ostojaatanasijevic/voltmeter_module/voltmeter_module.pdf

## MCP3651 based voltmeter module

10. januar 2025.

## Sadrˇzaj

1 Resolution | 3
2 Input amplifier ideas | 3
3 Calculating errors | 5
4 Power supply | 7

## 1 Resolution

MCP3651 ADC has a resolution of 24 bits, however, the 7 ppm max INL limits this multimeters count to 146000, just shy of 5.5 digit.
Keeping drift in 1 PPM range, 3 uV drift is acceptable over the temperature range.

1.1 Input current noise limit

Since for input ranges greater then Vcc the input voltage is feed through a 10 MOhm divider, input currents noise contribution is:

## 2 Input amplifier ideas

2.1 NCS21802 only

2.1.1 Input current noise at high voltage input NCS21802 has 450 fA√
Hz, meaning at input divider resistance (around 12 kOhm), voltage noise generated is 5.4nV/

√
Hz. At 1 kHz BW, peak to peak noise contribution of input current is 1.02 uVpp. At 1 Hz, input noise is 32 nVpp.

2.1.2 Input current noise at low voltage input

2.1.3 Input voltage noise

NCS has 400 nVpp below 10 Hz, while the 1 kHz noise spec of 42 nV/Hz would suggest 800 nVpp at that BW. If we use the 1 kHz figure, we can estimate 1 kHz BW noise is 8 uVpp. At 1 Hz, input voltage noise is 252 nVpp or less.

2.1.4 Total noise at high voltage input

Total noise is dominated by voltage noise, which is say 9 uVpp at 1 kHz, 260 nVpp at 1 Hz. Scaling to input range, 3V signal still has to go into the high voltage divider and is reduced to 4.5 mV.

2.1.5 IDK

If we want 500 updates a second, setting the bandwidth to 1000 Hz admits 1716 nVrms, or 10.3 uVpp of noise. Reducing the BW to 4 Hz, 0.6 uVpp.
With the proposed 10 Meg, 12.5 k divider, worst case scenario is 3V input voltage, yealding 3.75 mV across the input divider. In this case, noise reduces the voltmeter resolution to 500 counts. Averaging may improve this noise, but this is garantied to

2.2 TL072 and NCS
TL072 has 80 fA√
Hz, meaning at input divider resistance (around 100 kOhm), voltage noise generated is 8nV/

√
Hz. Noise is larger at 0.1 Hz, with peak to peak noise being 300 times larger then noise density at 1 kHz. Max pp noise is then 2.4 uVpp. The input voltage noise pp is 9.2 uVpp.

Vnoise =

p
9.2

2 + 2.4

2uV pp = 9.51uV pp | (1)

In order to retain the 5.5 digit resolution, input range cant go lower than 2V. At 4.5, input range is 0.2V.
If we want 500 updates a second, setting the bandwidth to 1000 Hz admits 1716 nVrms, or 10.3 uVpp of noise. Reducing the BW to 4 Hz, 0.6 uVpp.
With the proposed 10 Meg, 12.5 k divider, worst case scenario is 3V input voltage, yealding 3.75 mV across the input divider. In this case, noise reduces the voltmeter resolution to 500 counts.

2.3 Bootstrapped low voltage chopper amplifier input

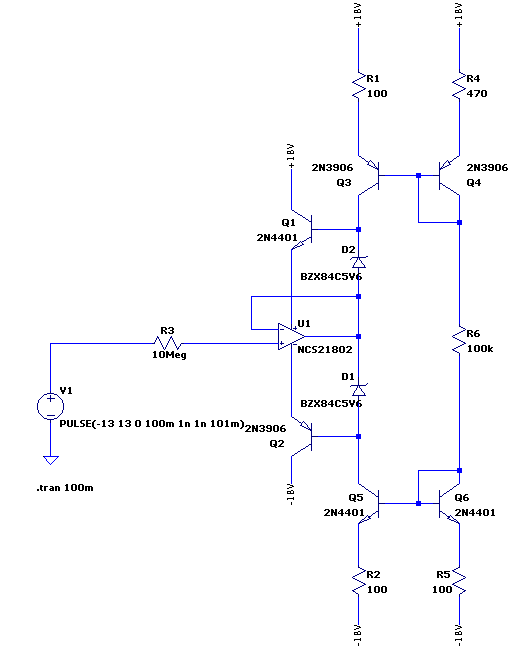
[picture p1: figure]

## 3 Calculating errors

3.1 Offset drift

The input stage is TL072 has typical of ±2 µV/°C and since the input stage features 2, one generating offset, total input drift is ±4 µV/°C.
This drift is lowered, as ±10V range gets mapped to 3.3 V range, meaning the offset drift contribution of TL072 is ±0.66µV/
◦C

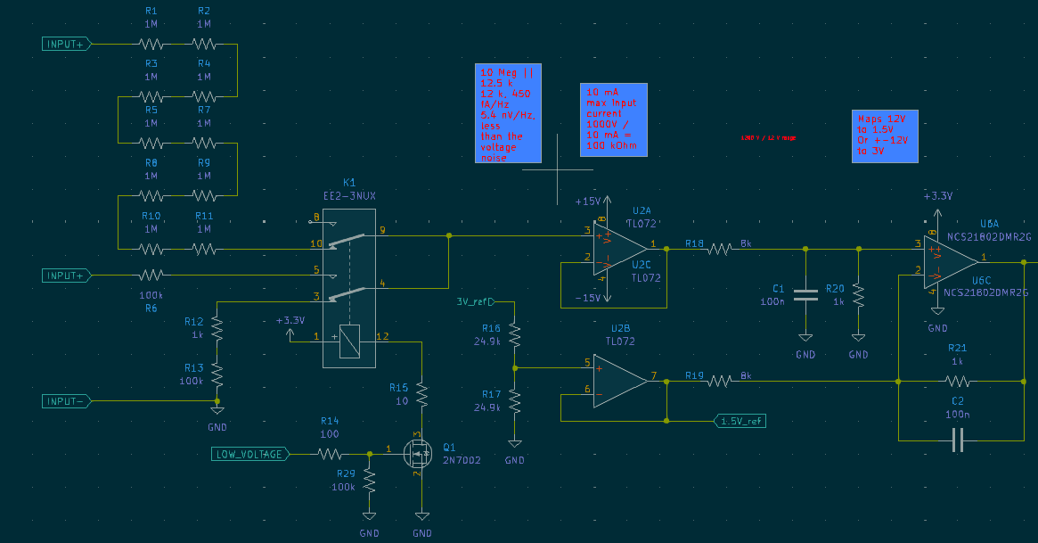
[picture p2: figure]

The second stage consist of two opamps, component NCS21802, with input offset of ±5 nV/°C. First opamp contributes ±5 nV/°C, while second opamps contribution depends on the selected gain. In the worst case, gain of 100, the second opamps contribution is ±0.5 µV/°C.
The ADC has an input offset drift of ±4 nV/°C, meaning the total input offset drift is:
Vos = Vtl072 + VNCS21802(1 + 100) + VADC | (2)

Vos = ±1.169µV/

◦C | (3)

Compared to full scale, drift is 0.35 PPM/°C, meaning for a 5.5 digit instrument, the drift is les than ±1 LSB for a temperature change of ±14 ◦C.

3.2 Gain drift

5.5 digit instruments have 5 PPM resolution.

## 4 Power supply

4.1 Mains transformer

Since leakage is not critical a this stage, +-18V mains transformer should suffice.
