ostojaatanasijevic/voltmeter_module/simulacije/002_bootstrapped_input_buffer.asc

D1: zener; PH_BZX884-B2V4
D2: zener; PH_BZX884-B2V4
Q1: npn; BC846B
Q2: npn; BC846B
Q3: pnp; BC856B
Q4: pnp; BC856B
Q5: npn; BC846B
Q7: pnp; BC856B
R1: res; 100
R2: res; 100
R3: res; 10Meg
R4: res; 470
R5: res; 100
R6: res; 100k
R7: res; 8k
R8: res; 8k
R9: res; 2k
R10: res; 1k
R11: res; 2k
R12: res; 2k
U1: opamp2; NCS21802
U2: opamp2; NCS21802
V1: voltage; PULSE(-12 12 0 100m 1n 1n 101m)
V2: voltage; 15V
V3: voltage; 15V
V4: voltage; 3
Named nets: 0, +18V, -18V
.tran 100m
.lib "NCS2180X SPICE MODEL.MOD"
