ostojaatanasijevic/voltmeter_module/simulacije/diode_check.asc

D1: zener; PH_BZX884-B2V4
D2: zener; PH_BZX884-B2V4
D3: zener; PH_BZX884-B2V4
Q1: pnp; 2N3906
R1: res; 20k
R2: res; 20k
R3: res; 20k
V1: voltage; 15V
V2: voltage; 15V
Named nets: +18V, 0
.lib "NCS2180X SPICE MODEL.MOD"
.tran 1m
