ostojaatanasijevic/voltmeter_module/simulacije/001_tl_ncs_combo.asc

R1: res; 10Meg
R2: res; 101k
R3: res; 2k
R4: res; 2k
R5: res; 2k
R6: res; 2k
R7: res; 2k
R8: res; 2k
R9: res; 2k
U1: TL072
U3: TL072
V1: voltage; 15
V2: voltage; -15
V3: voltage; -5
V4: voltage; 5
V5: voltage; PULSE(-1200 1200 0 10m 1u 1u 11m)
V6: voltage; 3
Named nets: 15V, -15V, 0, -5V, 5V, 3V
.tran 10m
