ostojaatanasijevic/voltmeter_module/simulacije/200_temperature_sensor.asc

B1: bv; V=575m + 2.64m * (V(temp) - 25)
R1: res; {Rf}
R2: res; {Rin}
R3: res; {Rin}
R4: res; {Rf}
R5: res; 4.7k
R6: res; 1k
U1: TL072
U2: TL072
V1: voltage; 15
V2: voltage; 15
V3: voltage; 3
V4: voltage; PULSE(0 50 0 100m 1u 1u 101m)
Named nets: 0, 15V, -15V, temp
.tran 102m
.param Rin = 1k
.param Rf = 25k
