ostojaatanasijevic/voltmeter_module/simulacije/100_push_pull.asc

C1: cap; 100p
C2: cap; 47µ
C3: cap; 10µ
C4: cap; 10µ
C5: cap; 47µ
C9: cap; 10µ
C10: cap; 10µ
C11: cap; 10µ
C12: cap; 10µ
D1: schottky; RB088LAM100
D2: schottky; RB088LAM100
I3: current; 50m
I4: current; 50m
L1: ind2; 1.8m; Rser=0.2
L2: ind2; 1.8m; Rser=0.2
L3: ind2; 900µ; Rser=0.4
L4: ind2; 900µ; Rser=0.4
M1: nmos; 2N7002
M2: nmos; 2N7002
Q2: pnp; 2N2905
R1: res; 1k
R2: res; 10
R3: res; 10
R4: res; 2.2k
R5: res; 1k
R6: res; 2.2k
U1: bd679
V2: voltage; PULSE(0 10 {0.5/f} 10n 10n {d/f}   {1/f})
V3: voltage; PULSE(0 10 {0} 10n 10n {d/f} {1/f})
V4: voltage; 12
Named nets: 0, GATE_B, GATE_A, -V_DRV_HS, +V_DRV_HS, vcc_in
.tran 100m
K1  L1 L2 L3 L4 1
.param f = 20k
.param d=0.4
