ostojaatanasijevic/voltmeter_module/simulacije/000_input_protection.asc

R3: res; 10Meg
U1: opamp2; NCS21802
V1: voltage; PULSE(-1000 1000 0 100m 1n 1n 101m)
V2: voltage; 5
Named nets: 0, 3.3V
.tran 100m
.lib "Z:\\home\\ostoja\\Elektronika\\voltmeter_module\\simulacije\\NCS2180X SPICE MODEL.MOD"
