ostojaatanasijevic/voltmeter_module/voltmeter_module.kicad_pcb

## KiCad design voltmeter_module.kicad_pcb (2025-01-10)

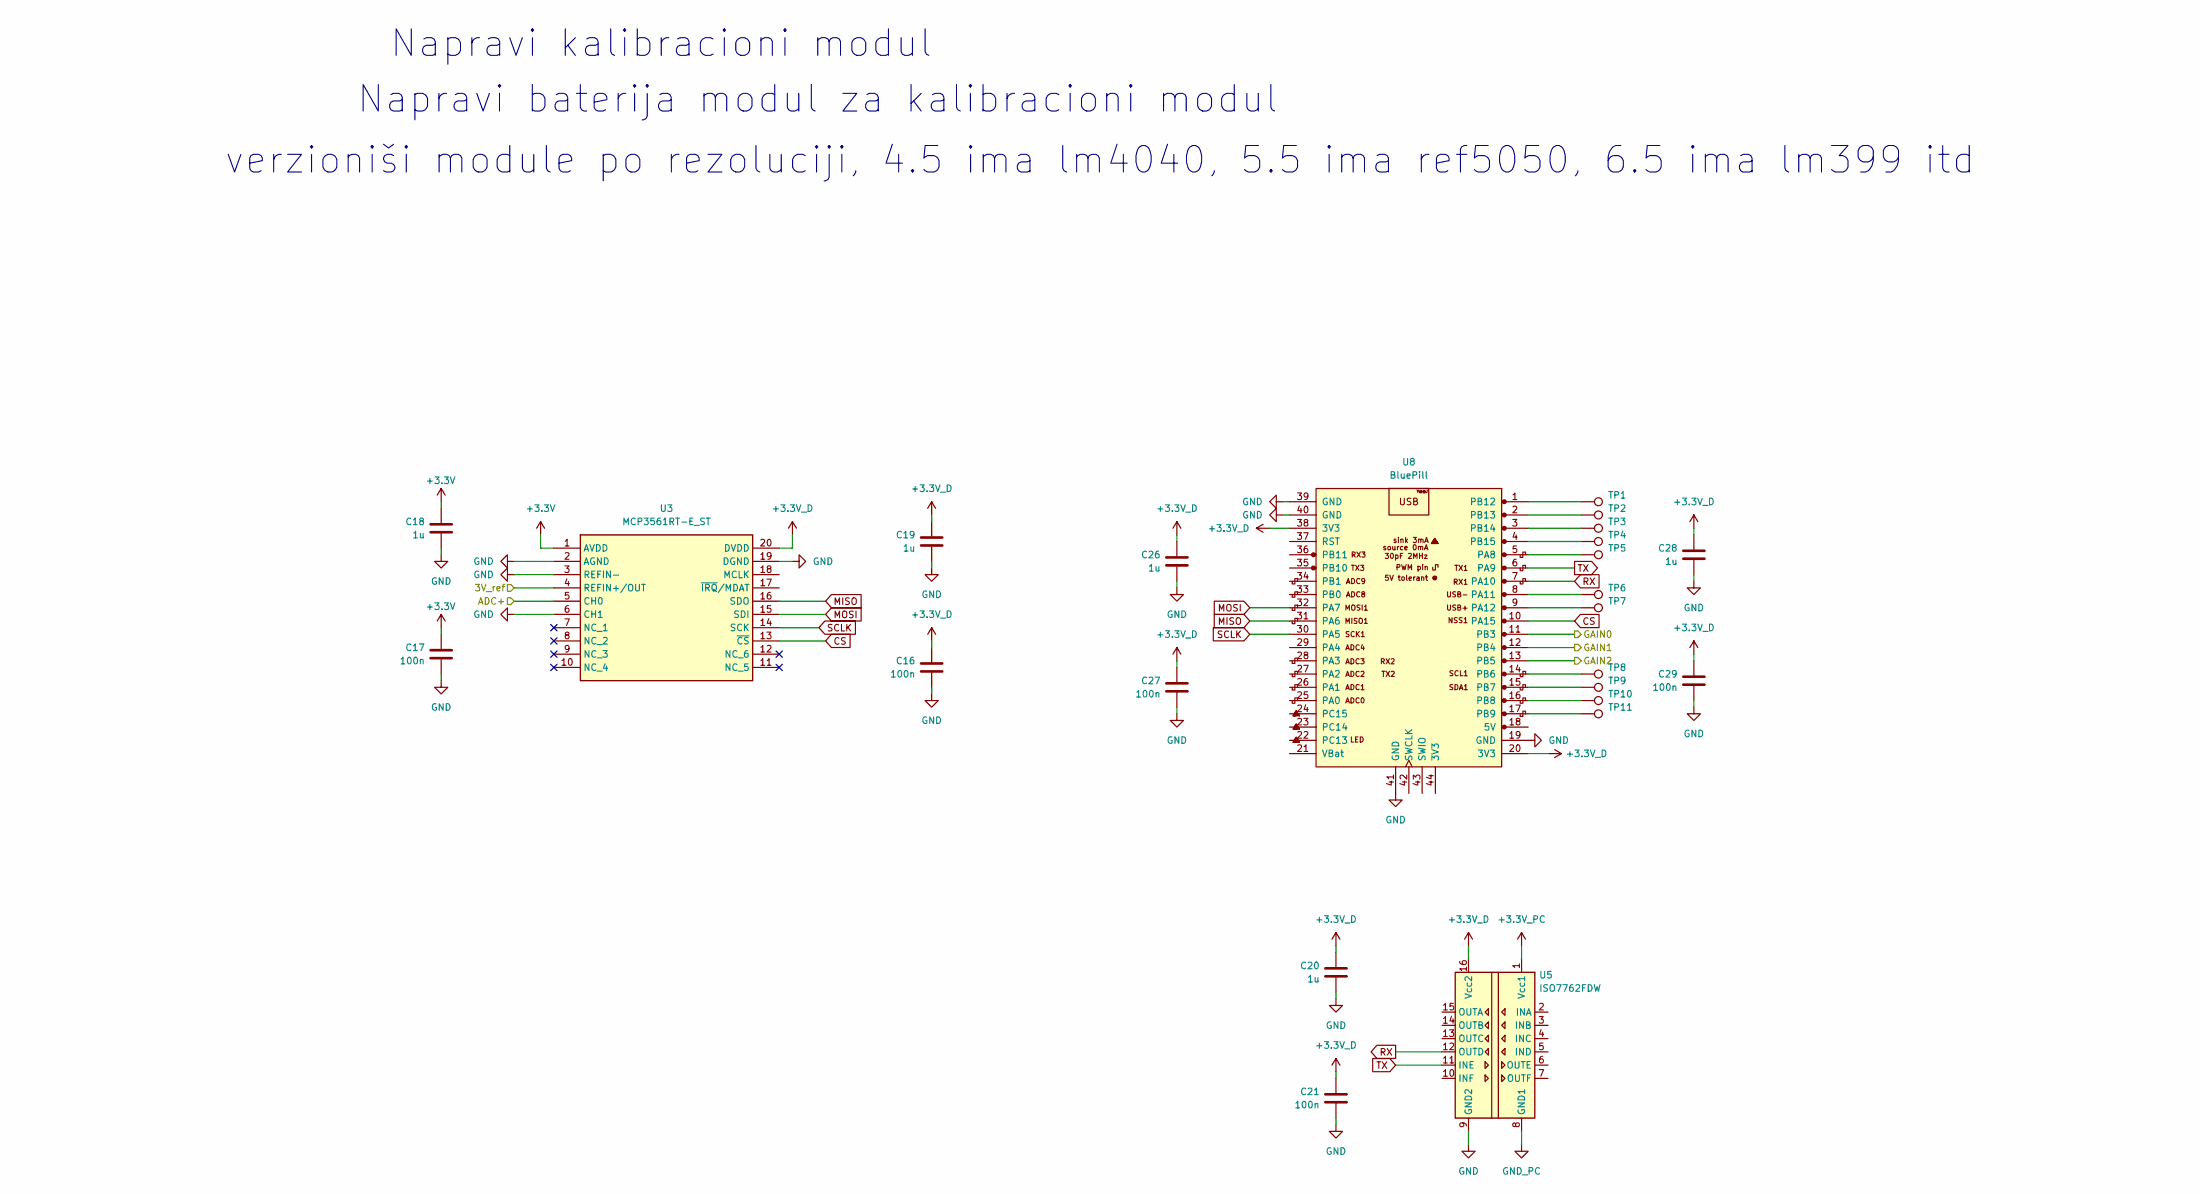
[picture p3: schematic digital_section.kicad_sch]

Parts:
C16, C17, C21, C27, C29: 100n; C_0603_1608Metric_Pad1.08x0.95mm_HandSolder
C18, C19, C20, C26, C28: 1u; C_0603_1608Metric_Pad1.08x0.95mm_HandSolder
TP1, TP2, TP3, TP4, TP5, TP6, TP7, TP8, TP9, TP10, TP11: TestPoint; TestPoint_Pad_D3.0mm
U3: MCP3561RT-E_ST; TSSOP-20_4.4x6.5mm_P0.65mm; Mouser Part Number 579-MCP3561RT-E/ST
U5: ISO7762FDW; SOIC-16W_7.5x10.3mm_P1.27mm
U8: BluePill

Connections:
+3.3V: C17.2, C18.2, U3.1 (AVDD); also elsewhere on the board
+3.3V_D: C16.2, C19.2, C20.2, C21.2, C26.2, C27.2, C28.2, C29.2, U3.20 (DVDD), U5.16 (Vcc2), U8.20 (3V3), U8.38 (3V3); also elsewhere on the board
+3.3V_PC: U5.1 (Vcc1); also elsewhere on the board
/Digital section/3V_ref: U3.4 (REFIN+/OUT); also elsewhere on the board
/Digital section/ADC+: U3.5 (CH0); also elsewhere on the board
CS: U3.13 (~CS), U8.10 (PA15)
GND_PC: U5.8 (GND1); also elsewhere on the board
INPUT-: C16.1, C17.1, C18.1, C19.1, C20.1, C21.1, C26.1, C27.1, C28.1, C29.1, U3.2 (AGND), U3.3 (REFIN-), U3.6 (CH1), U3.19 (DGND), U5.9 (GND2), U8.19 (GND), U8.39 (GND), U8.40 (GND), U8.41 (GND); also elsewhere on the board
MISO: U3.16 (SDO), U8.31 (PA6)
MOSI: U3.15 (SDI), U8.32 (PA7)
unnamed: TP5.1, U8.5 (PA8)
unnamed: TP6.1, U8.8 (PA11)
unnamed: TP7.1, U8.9 (PA12)
unnamed: TP8.1, U8.14 (PB6)
unnamed: TP9.1, U8.15 (PB7)
unnamed: TP10.1, U8.16 (PB8)
unnamed: TP11.1, U8.17 (PB9)
unnamed: TP1.1, U8.1 (PB12)
unnamed: TP2.1, U8.2 (PB13)
unnamed: TP3.1, U8.3 (PB14)
unnamed: TP4.1, U8.4 (PB15)
RX: U5.12 (OUTD), U8.7 (PA10)
SCLK: U3.14 (SCK), U8.30 (PA5)
TX: U5.11 (INE), U8.6 (PA9)

Notes on the sheet:
verzioniši module po rezoluciji, 4.5 ima lm4040, 5.5 ima ref5050, 6.5 ima lm399 itd
Napravi kalibracioni modul
Napravi baterija modul za kalibracioni modul

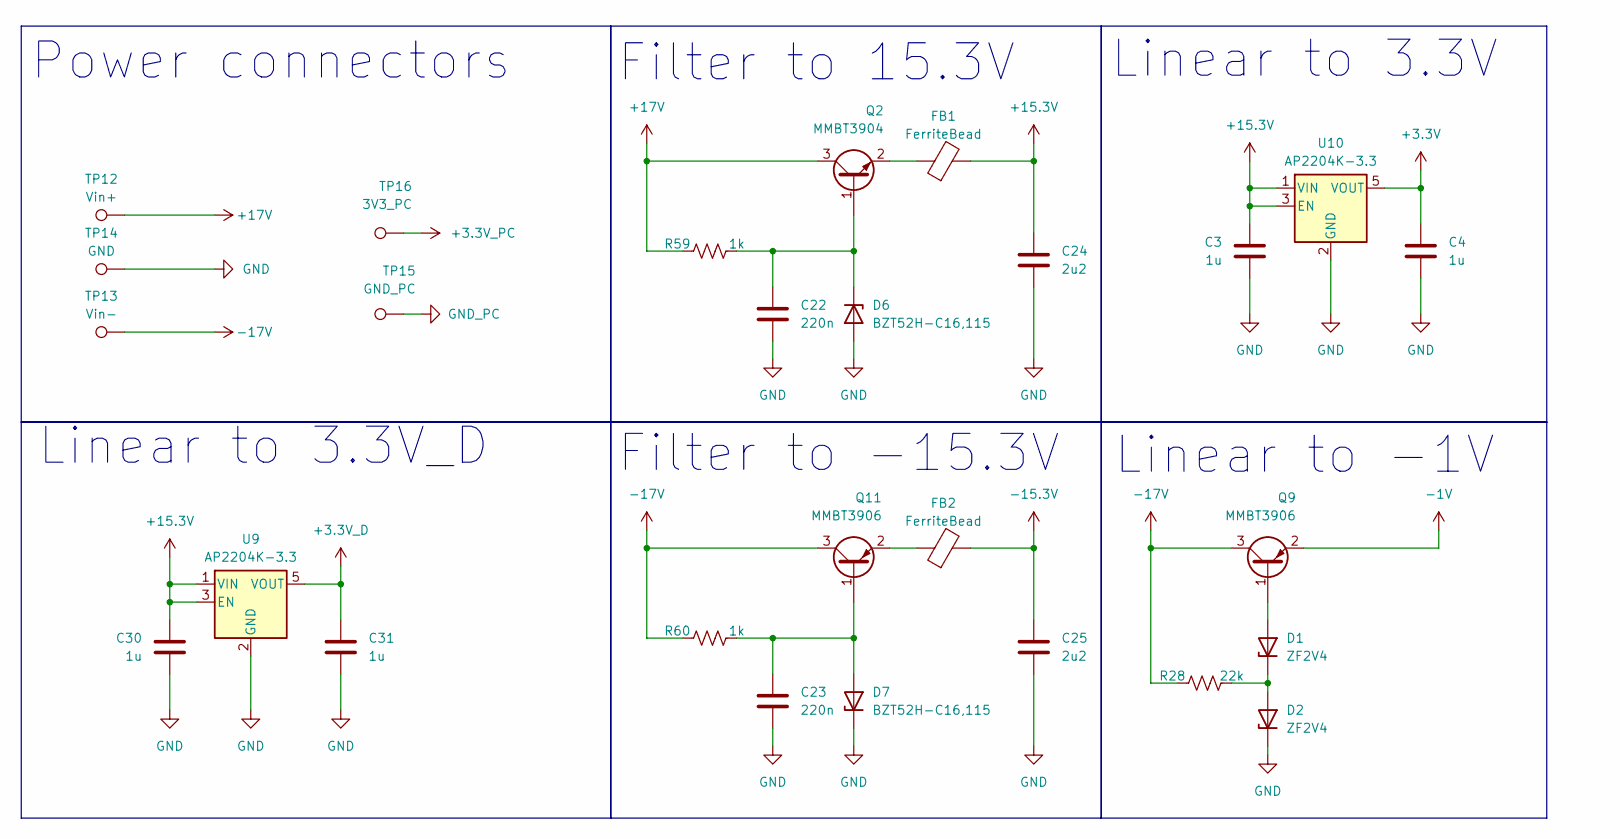
[picture p4: schematic power_supply.kicad_sch]

Parts:
C3, C4, C30, C31: 1u; R_0603_1608Metric_Pad0.98x0.95mm_HandSolder
C22, C23: 220n; R_0603_1608Metric_Pad0.98x0.95mm_HandSolder
C24, C25: 2u2; R_1206_3216Metric_Pad1.30x1.75mm_HandSolder
D1, D2: ZF2V4; D_DO-35_SOD27_P7.62mm_Horizontal
D6, D7: BZT52H-C16,115; D_SOD-123F
FB1, FB2: FerriteBead
Q2: MMBT3904; SOT-23
Q9, Q11: MMBT3906; SOT-23
R28: 22k; R_0603_1608Metric_Pad0.98x0.95mm_HandSolder
R59, R60: 1k; R_0603_1608Metric_Pad0.98x0.95mm_HandSolder
TP12: Vin+; TestPoint_THTPad_D4.0mm_Drill2.0mm
TP13: Vin-; TestPoint_THTPad_D4.0mm_Drill2.0mm
TP14: GND; TestPoint_THTPad_D4.0mm_Drill2.0mm
TP15: GND_PC; TestPoint_THTPad_D4.0mm_Drill2.0mm
TP16: 3V3_PC; TestPoint_THTPad_D4.0mm_Drill2.0mm
U9, U10: AP2204K-3.3; SOT-23-5

Connections:
+3.3V: C4.1, U10.5 (VOUT); also elsewhere on the board
+3.3V_D: C31.1, U9.5 (VOUT); also elsewhere on the board
+3.3V_PC: TP16.1; also elsewhere on the board
+15.3V: C3.1, C24.2, C30.1, FB1.2, U9.1 (VIN), U9.3 (EN), U10.1 (VIN), U10.3 (EN); also elsewhere on the board
+17V: Q2.3 (C), R59.2, TP12.1
-1V: Q9.2 (E); also elsewhere on the board
-15.3V: C25.2, FB2.2; also elsewhere on the board
-17V: Q9.3 (C), Q11.3 (C), R28.2, R60.2, TP13.1
GND_PC: TP15.1; also elsewhere on the board
INPUT-: C3.2, C4.2, C22.2, C23.2, C24.1, C25.1, C30.2, C31.2, D2.1 (K), D6.2 (A), D7.1 (K), TP14.1, U9.2 (GND), U10.2 (GND); also elsewhere on the board
unnamed: D1.2 (A), Q9.1 (B)
unnamed: D1.1 (K), D2.2 (A), R28.1
unnamed: C22.1, D6.1 (K), Q2.1 (B), R59.1
unnamed: C23.1, D7.2 (A), Q11.1 (B), R60.1
unnamed: FB1.1, Q2.2 (E)
unnamed: FB2.1, Q11.2 (E)

Notes on the sheet:
Linear to 3.3V_D
Filter to 15.3V
Linear to -1V
Power connectors
Linear to 3.3V
Filter to -15.3V

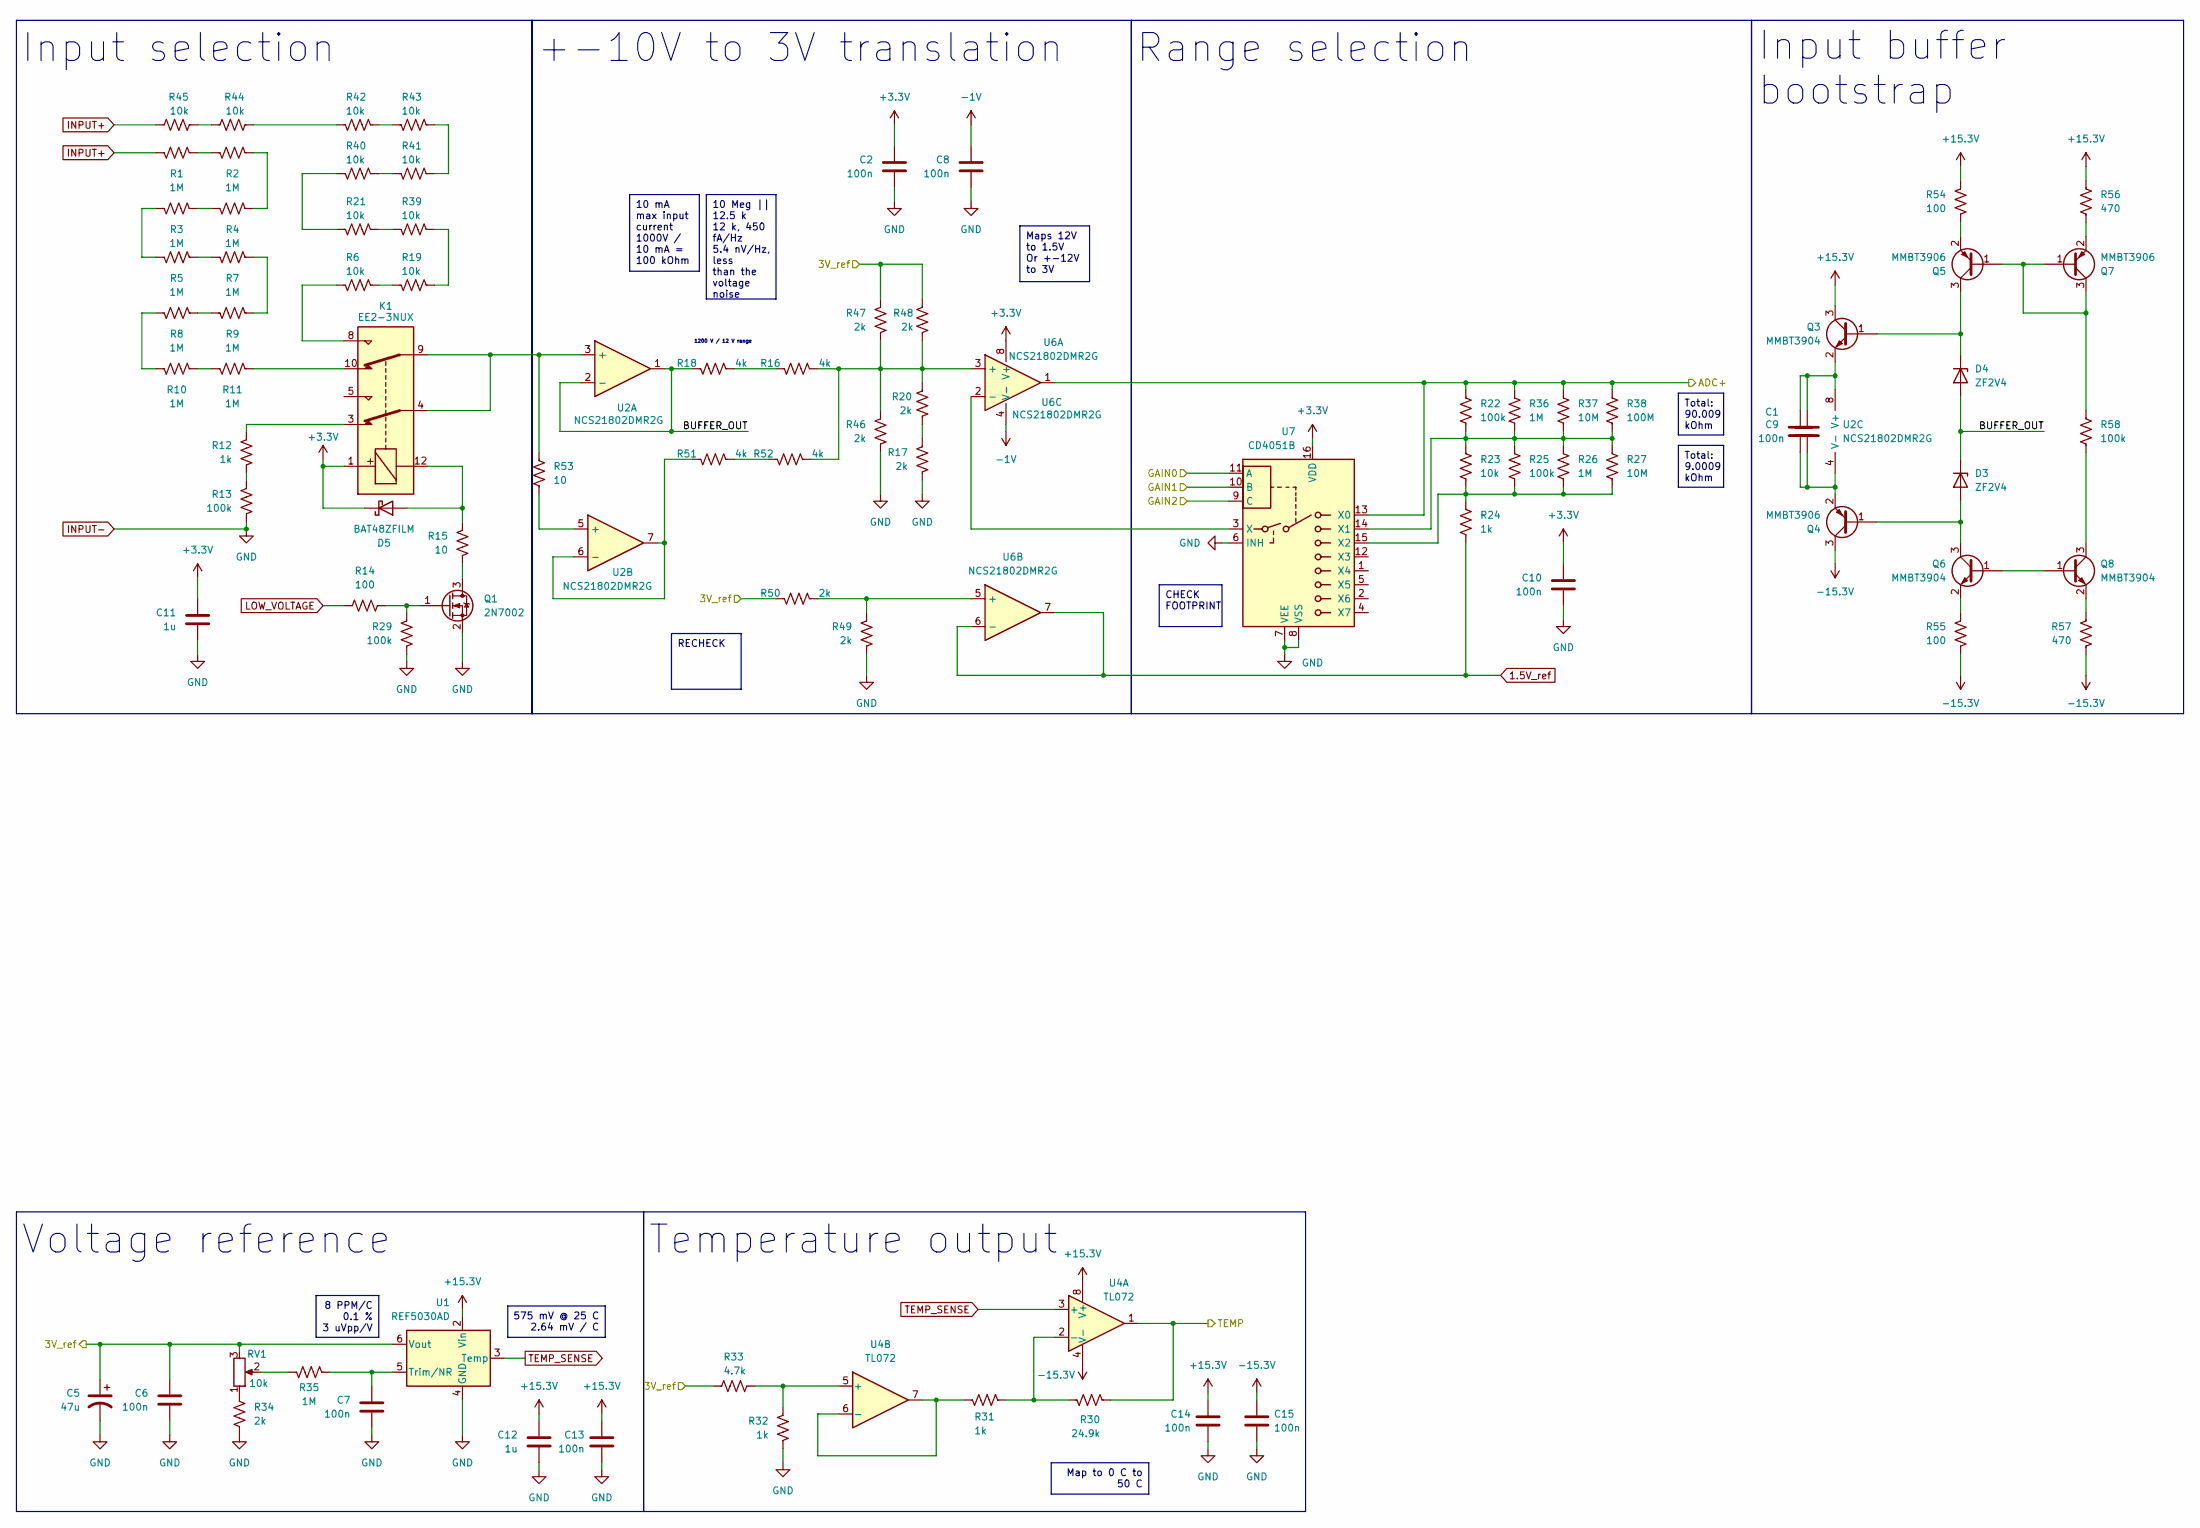
[picture p5: schematic input_stage.kicad_sch]

Parts:
C1, C2, C6, C7, C8, C9, C10, C13, C14, C15: 100n; C_0603_1608Metric_Pad1.08x0.95mm_HandSolder
C5: 47u; CP_Radial_D5.0mm_P2.00mm
C11, C12: 1u; C_0603_1608Metric_Pad1.08x0.95mm_HandSolder
D3, D4: ZF2V4; D_DO-35_SOD27_P7.62mm_Horizontal
D5: BAT48ZFILM; D_SOD-123
K1: EE2-3NUX; Relay_DPDT_Kemet_EE2_NUX_NKX
Q1: 2N7002; SOT-23
Q3, Q6, Q8: MMBT3904; SOT-23
Q4, Q5, Q7: MMBT3906; SOT-23
R1, R2, R3, R4, R5, R7, R8, R9, R10, R11: 1M; R_1206_3216Metric_Pad1.30x1.75mm_HandSolder
R6, R19, R21, R23, R39, R40, R41, R42, R43, R44, R45: 10k; R_0603_1608Metric_Pad0.98x0.95mm_HandSolder
R12, R24, R31, R32: 1k; R_0603_1608Metric_Pad0.98x0.95mm_HandSolder
R13, R22, R25, R29, R58: 100k; R_0603_1608Metric_Pad0.98x0.95mm_HandSolder
R14, R54, R55: 100; R_0603_1608Metric_Pad0.98x0.95mm_HandSolder
R15, R53: 10; R_0603_1608Metric_Pad0.98x0.95mm_HandSolder
R16, R18, R51, R52: 4k; R_0603_1608Metric_Pad0.98x0.95mm_HandSolder
R17, R20, R34, R46, R47, R48, R49, R50: 2k; R_0603_1608Metric_Pad0.98x0.95mm_HandSolder
R26, R35, R36: 1M; R_0603_1608Metric_Pad0.98x0.95mm_HandSolder
R27, R37: 10M; R_0603_1608Metric_Pad0.98x0.95mm_HandSolder
R30: 24.9k; R_0603_1608Metric_Pad0.98x0.95mm_HandSolder
R33: 4.7k; R_0603_1608Metric_Pad0.98x0.95mm_HandSolder
R38: 100M; R_0603_1608Metric_Pad0.98x0.95mm_HandSolder
R56, R57: 470; R_0603_1608Metric_Pad0.98x0.95mm_HandSolder
RV1: 10k; Potentiometer_Bourns_3296W_Vertical
U1: REF5030AD; SOIC-8_3.9x4.9mm_P1.27mm
U2, U6: NCS21802DMR2G; OnSemi_Micro8
U4: TL072; SOIC-8_3.9x4.9mm_P1.27mm
U7: CD4051B; SOIC-16_3.9x9.9mm_P1.27mm

Connections:
1.5V_ref: R24.1, U6.6 (-), U6.7
+3.3V: C2.2, C10.2, C11.2, D5.1 (K), K1.1, U6.8 (V+), U7.16 (VDD); also elsewhere on the board
+15.3V: C12.2, C13.2, C14.2, Q3.3 (C), R54.2, R56.2, U1.2 (Vin), U4.8 (V+); also elsewhere on the board
-1V: C8.2, U6.4 (V-); also elsewhere on the board
-15.3V: C15.2, Q4.3 (C), R55.1, R57.1, U4.4 (V-); also elsewhere on the board
/Digital section/3V_ref: R22.2, R36.2, R37.2, R38.2, U6.1, U7.13 (X0); also elsewhere on the board
/Digital section/ADC+: C5.1, C6.2, R33.1, R47.2, R48.2, R50.2, RV1.3, U1.6 (Vout); also elsewhere on the board
/Digital section/GAIN0: U7.11 (A)
/Digital section/GAIN1: U7.10 (B)
/Digital section/GAIN2: U7.9 (C)
/Input stage/BUFFER_OUT: D3.1 (K), D4.2 (A), R18.2, U2.1, U2.2 (-)
/Input stage/TEMP: R30.1, U4.1
INPUT+: R1.1, R45.2
INPUT-: C2.1, C5.2, C6.1, C7.1, C8.1, C10.1, C11.1, C12.1, C13.1, C14.1, C15.1, Q1.2 (S), R13.1, R17.1, R29.1, R32.1, R34.1, R46.1, R49.1, U1.4 (GND), U7.6 (INH), U7.7 (VEE), U7.8 (VSS); also elsewhere on the board
LOW_VOLTAGE: R14.2
unnamed: D3.2 (A), Q4.1 (B), Q6.3 (C)
unnamed: D4.1 (K), Q3.1 (B), Q5.3 (C)
unnamed: D5.2 (A), K1.12, R15.2
unnamed: K1.3, R12.2
unnamed: K1.8, R6.1
unnamed: K1.10, R11.2
unnamed: Q1.3 (D), R15.1
unnamed: Q1.1 (G), R14.1, R29.2
unnamed: C1.2, C9.2, Q3.2 (E), U2.8 (V+)
unnamed: C1.1, C9.1, Q4.2 (E), U2.4 (V-)
unnamed: Q5.1 (B), Q7.1 (B), Q7.3 (C), R58.2
unnamed: Q5.2 (E), R54.1
unnamed: Q6.1 (B), Q8.1 (B)
unnamed: Q6.2 (E), R55.2
unnamed: Q7.2 (E), R56.1
unnamed: Q8.3 (C), R58.1
unnamed: Q8.2 (E), R57.2
unnamed: R1.2, R2.1
unnamed: R2.2, R4.2
unnamed: R3.1, R5.1
unnamed: R3.2, R4.1
unnamed: R5.2, R7.1
unnamed: R7.2, R9.2
unnamed: R8.2, R9.1
unnamed: R8.1, R10.1
unnamed: R10.2, R11.1
unnamed: R12.1, R13.2
unnamed: R16.2, R18.1
unnamed: R17.2, R20.1
unnamed: R6.2, R19.1
unnamed: R19.2, R39.2
unnamed: R21.1, R40.1
unnamed: R21.2, R39.1
unnamed: R34.2, RV1.1
unnamed: R35.2, RV1.2
unnamed: R40.2, R41.1
unnamed: R41.2, R43.2
unnamed: R42.1, R44.1
unnamed: R42.2, R43.1
unnamed: R44.2, R45.1
unnamed: R51.1, R52.2
unnamed: C7.2, R35.1, U1.5 (Trim/NR)
unnamed: K1.4, K1.9, R53.2, U2.3 (+)
unnamed: R53.1, U2.5 (+)
unnamed: R51.2, U2.6 (-), U2.7
unnamed: R30.2, R31.2, U4.2 (-)
unnamed: R32.2, R33.2, U4.5 (+)
unnamed: R31.1, U4.6 (-), U4.7
unnamed: R16.1, R20.2, R46.2, R47.1, R48.1, R52.1, U6.3 (+)
unnamed: U6.2 (-), U7.3 (X)
unnamed: R49.2, R50.1, U6.5 (+)
unnamed: R22.1, R23.2, R25.2, R26.2, R27.2, R36.1, R37.1, R38.1, U7.14 (X1)
unnamed: R23.1, R24.2, R25.1, R26.1, R27.1, U7.15 (X2)
TEMP_SENSE: U1.3 (Temp), U4.3 (+)

Notes on the sheet:
CHECK FOOTPRINT
8 PPM/C 0.1 % 3 uVpp/V
575 mV @ 25 C 2.64 mV / C
Maps 12V to 1.5V Or +-12V to 3V
Total: 90.009 kOhm
Map to 0 C to 50 C
RECHECK
10 Meg || 12.5 k 12 k, 450 fA/Hz 5.4 nV/Hz, less than the voltage noise
10 mA max input current 1000V / 10 mA = 100 kOhm
Total: 9.0009 kOhm
Temperature output
Input buffer bootstrap
Range selection
Input selection
+-10V to 3V translation
1200 V / 12 V range
Voltage reference

Board: 2 copper layers, 135 parts (0 on the bottom side), 74 nets, no tracks yet.
