ostojaatanasijevic/voltmeter_module/(commit log)

2024-10-29 To je to otp
    [voltmeter_module.kicad_sch]
2024-10-29 Add millivolt input.
    [voltmeter_module.kicad_sch]
2024-10-30 TL072 for the win.
    [digital_section.kicad_sch, input_stage.kicad_sch, power_supply.kicad_sch, voltmeter_module.kicad_pcb, voltmeter_module.kicad_sch]
2024-11-03 Added temperature, ref trimming and range selection resisitors.
    [digital_section.kicad_sch, input_stage.kicad_sch]
2024-11-09 Fixed diff amp.
    [input_stage.kicad_sch]
2024-11-10 Improved gain stage.
    [input_stage.kicad_sch]
2024-11-12 sqrt2 noise
    [input_stage.kicad_sch]
2024-11-12 fixed resistor
    [input_stage.kicad_sch]
2024-11-13 on MCU
    on MCU
    [digital_section.kicad_sch]
2025-01-10 Bootstraped input buffer.
    [digital_section.kicad_sch, input_stage.kicad_sch, power_supply.kicad_sch, voltmeter_module.kicad_pcb]
2025-01-19 Mora se poraditi na MCK pinu.
    [digital_section.kicad_sch, input_stage.kicad_sch]
